philippedc/ALS162-an-alternative-to-DCF77-time-radio-receiver-with-Arduino-Uno/Schematic_ALS162_2023-08-11.pdf

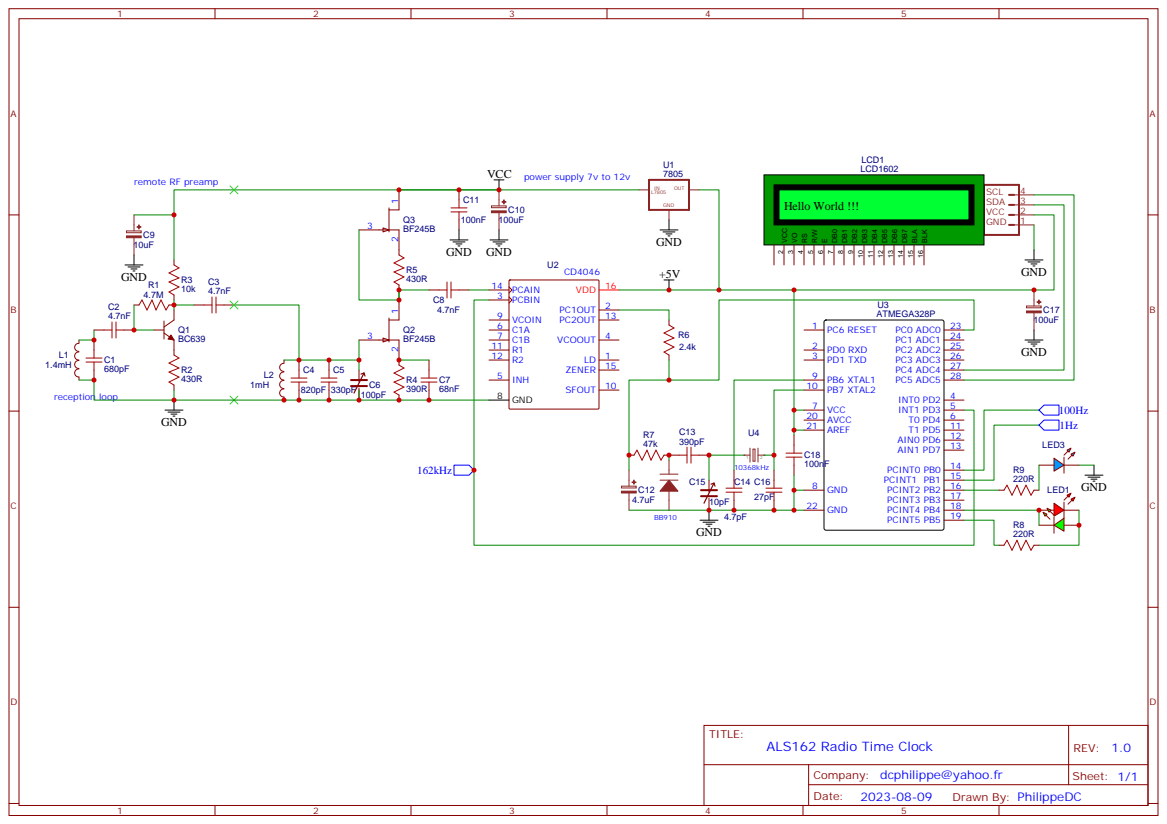
[picture p17: page 1]

Company: dcphilippe@yahoo.fr
